Spezialtrick/HM-MyS-Relay-Board/Schematic/1.1/HM-MYS_relay_board_v1.1_top.jpg

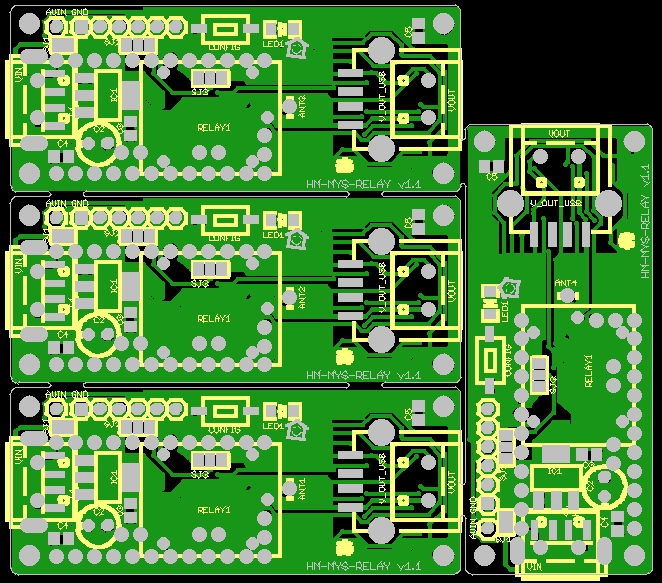
Schematic/1.1/HM-MYS_relay_board_v1.1_top.jpg
