Spezialtrick/HM-MyS-Relay-Board/Images/RelayBoard-1.0-3.jpg

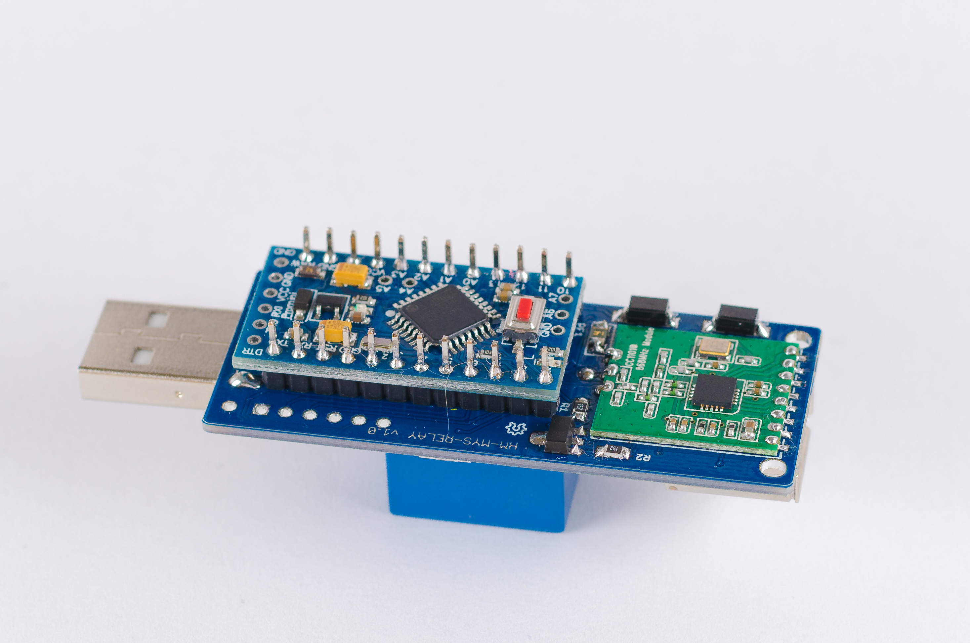
Images/RelayBoard-1.0-3.jpg
