Spezialtrick/HM-MyS-Relay-Board/README.md

# HM-MyS-Relay-Board

https://forum.fhem.de/index.php/topic,48235.0.html
