Spezialtrick/HM-MyS-Relay-Board/Case/Bildschirmfoto 2016-05-17 um 20.59.44.png

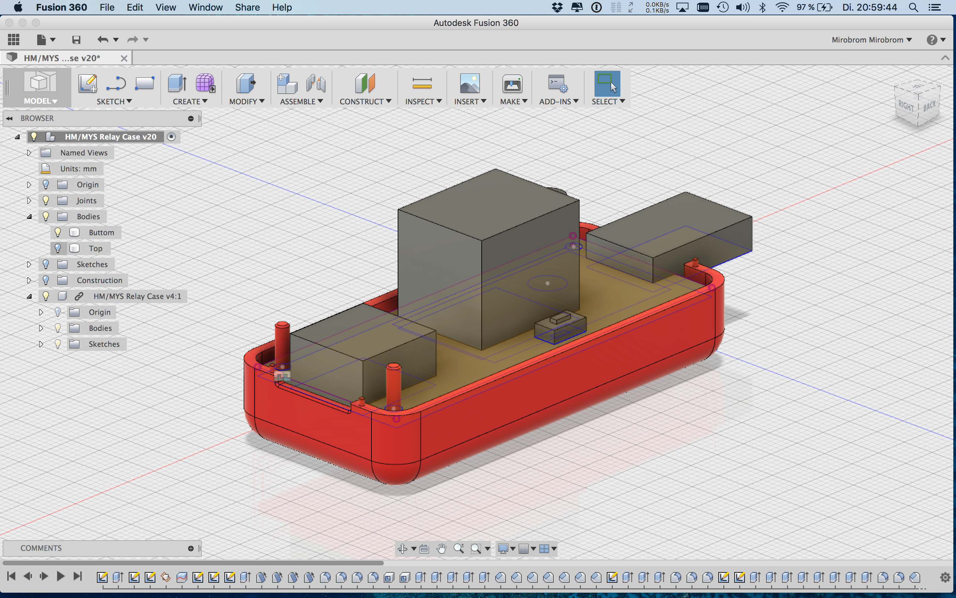
Case/Bildschirmfoto 2016-05-17 um 20.59.44.png
