Spezialtrick/HM-MyS-Relay-Board/Case/Bildschirmfoto 2016-05-17 um 21.00.06.png

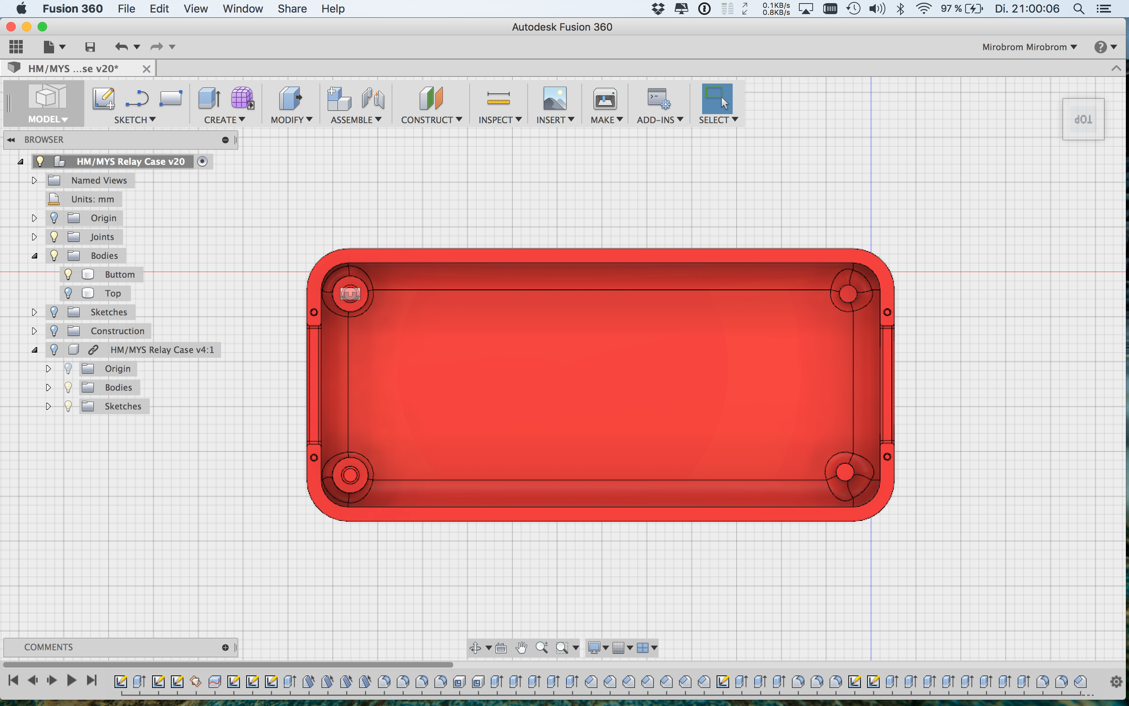
Case/Bildschirmfoto 2016-05-17 um 21.00.06.png
