Spezialtrick/HM-MyS-Relay-Board/Images/RelayBoard-1.0-1.jpg

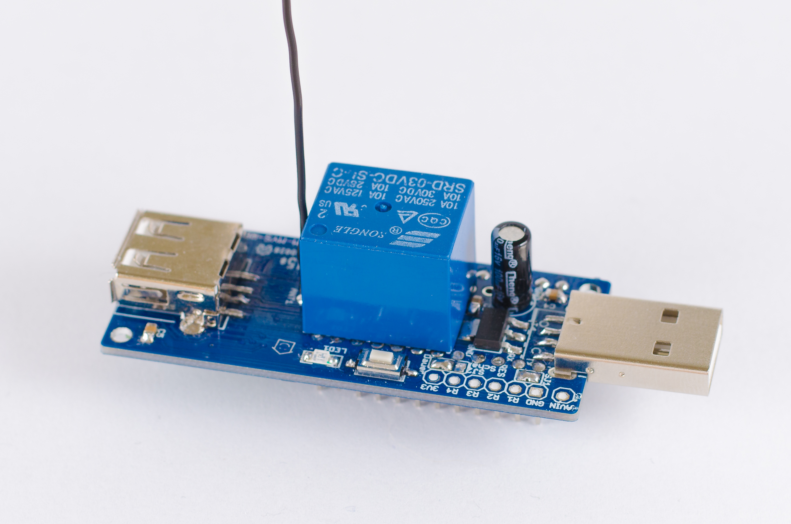
Images/RelayBoard-1.0-1.jpg
