Spezialtrick/HM-MyS-Relay-Board/Images/RelayBoard-1.0-2.jpg

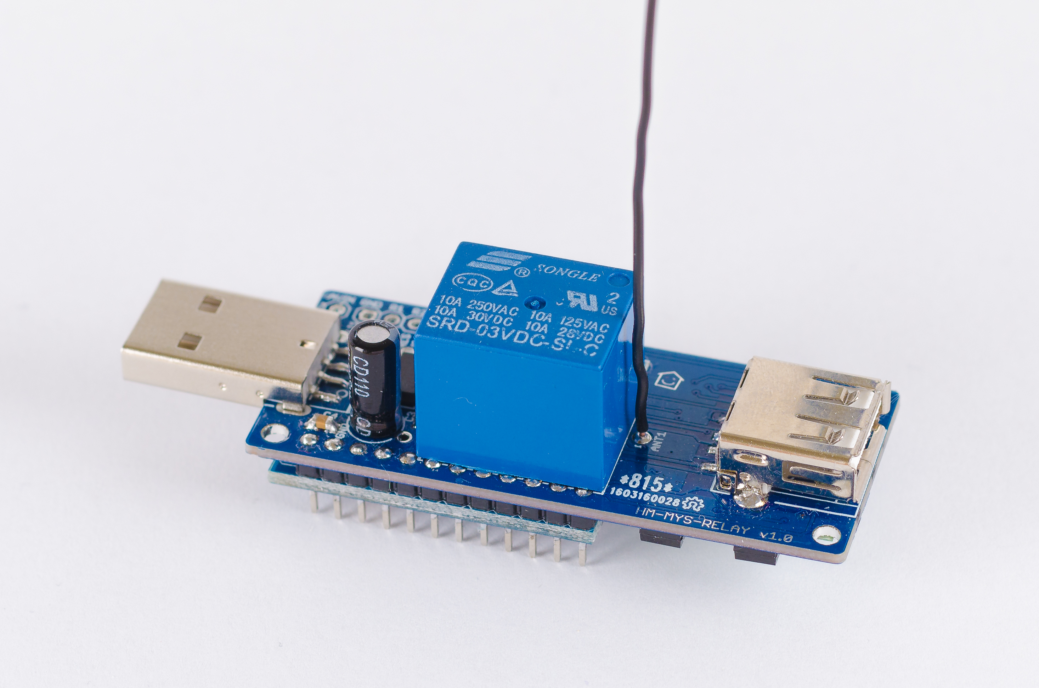
Images/RelayBoard-1.0-2.jpg
