Spezialtrick/HM-MyS-Relay-Board/Images/RelayBoard-1.0-4.jpg

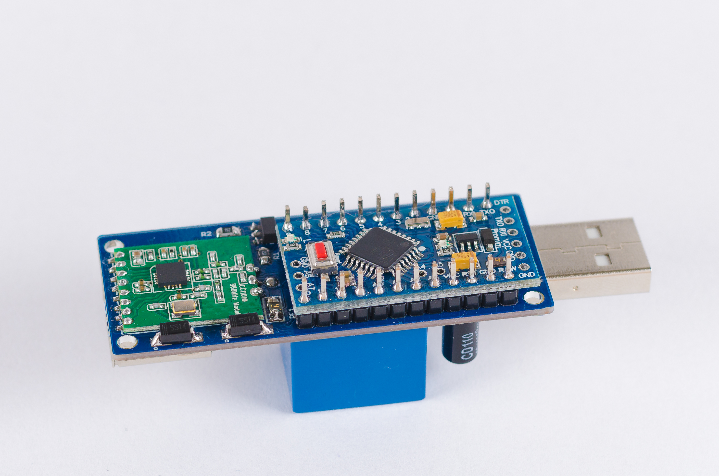
Images/RelayBoard-1.0-4.jpg
