Spezialtrick/HM-MyS-Relay-Board/Case/Bottom.stl

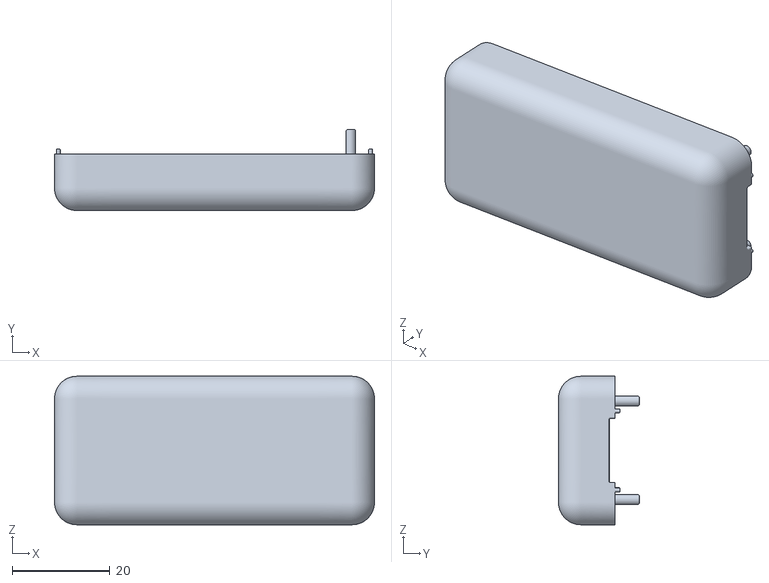
[picture p14: CAD file, 2017-06-06]
Case/Bottom.stl
65.5 x 16.6 x 30.4
