Spezialtrick/HM-MyS-Relay-Board/Schematic/1.1/Partslist.pdf

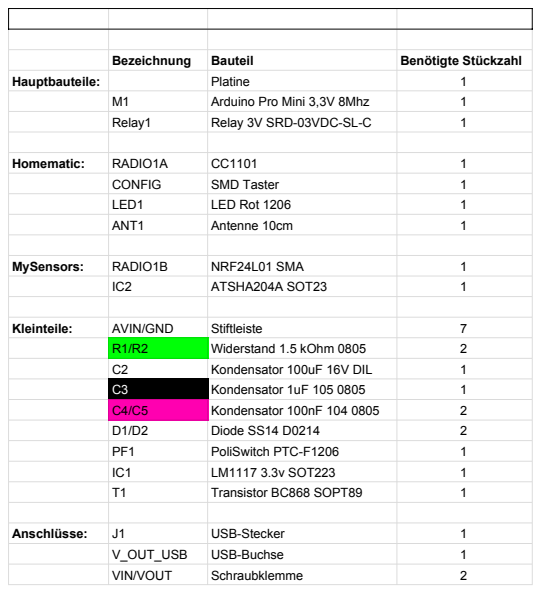
[picture p15: page 1]
Bezeichnung; Bauteil; Benötigte Stückzahl; Hauptbauteile:; Platine; Arduino Pro Mini 3,3V 8Mhz; Relay1; Relay 3V SRD-03VDC-SL-C; Homematic:; RADIO1A; CONFIG; SMD Taster; LED1; LED Rot 1206; ANT1; Antenne 10cm; MySensors:; RADIO1B; NRF24L01 SMA; ATSHA204A SOT23; Kleinteile:; AVIN/GND; Stiftleiste; Widerstand 1.5 kOhm 0805; Kondensator 100uF 16V DIL; Diode SS14 D0214; PoliSwitch PTC-F1206; LM1117 3.3v SOT223; Transistor BC868 SOPT89; Anschlüsse:; USB-Stecker; V_OUT_USB; USB-Buchse; VIN/VOUT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

C3 | Kondensator 1uF 105 0805 1
C4/C5 | Kondensator 100nF 104 0805 2
