Spezialtrick/HM-MyS-Relay-Board/Schematic/1.1/HM-MYS_relay_board_v1.1.brd

## EAGLE design Schematic/1.1/HM-MYS_relay_board_v1.1.brd (2017-07-14)

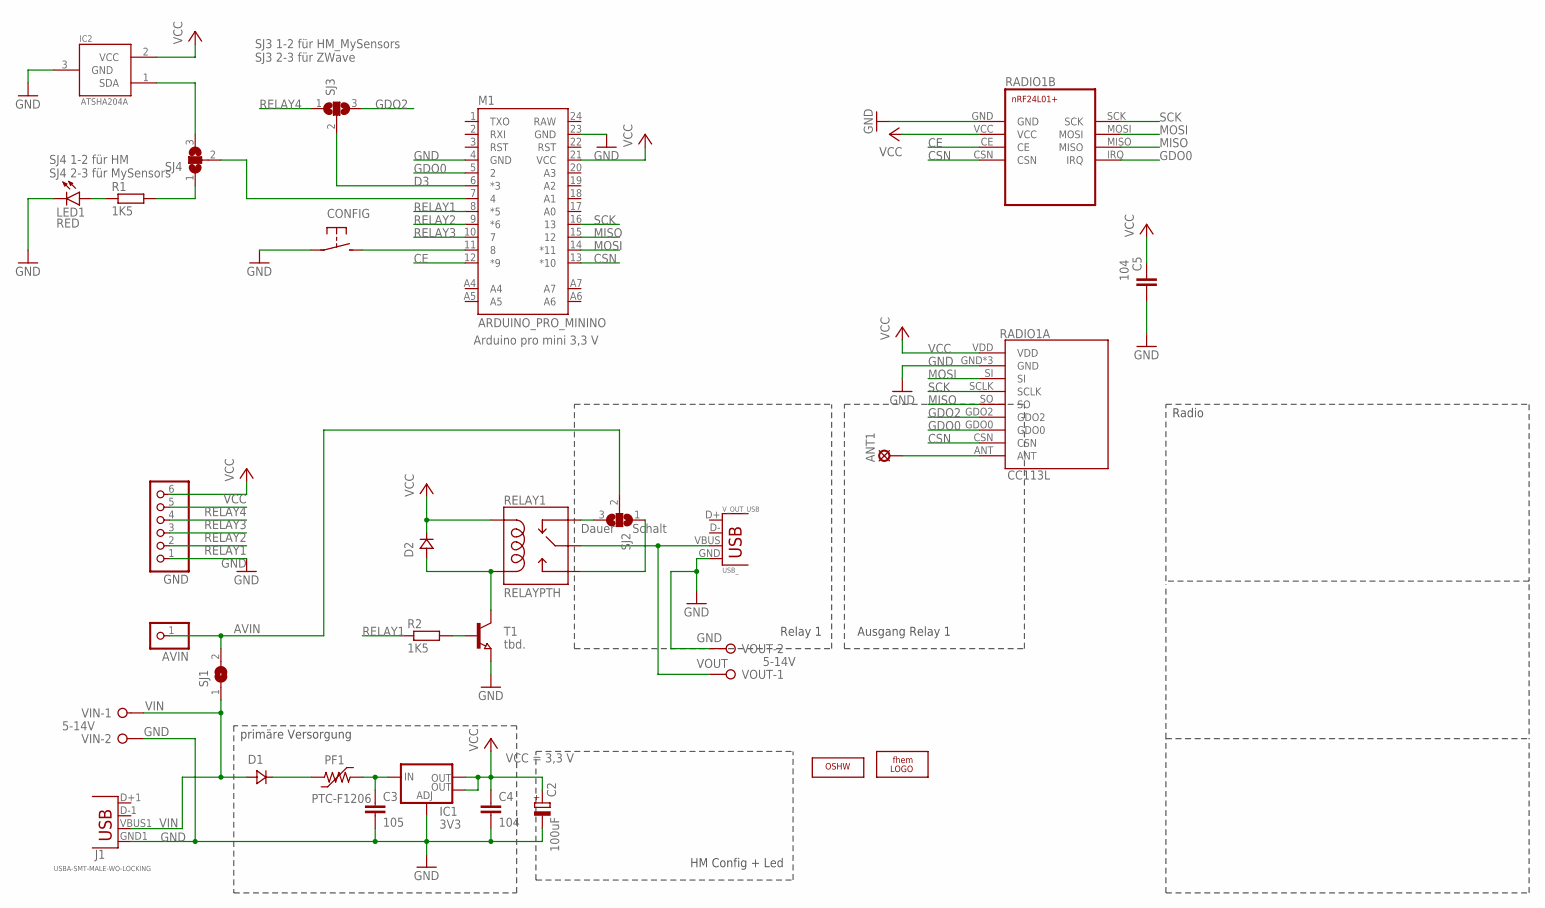
[picture p16: schematic HM-MYS_relay_board_v1.1.sch]

Parts:
ANT1: LSP10
AVIN: PINHD-1X1; 1X01
C2: 100uF; E2,5-6E
C3: 105; C0805
C4, C5: 104; C0805
CONFIG: TASTER-SMD
D1, D2: SS14; DO214
GND: PINHD-1X6_S; 1X06
IC1: 3V3; SOT223
IC2: ATSHA204A; SOT23-3
J1: USBA-SMT-MALE-WO-LOCKING; USB-A-SMT-MALE-NO_LOCKING
LED1: RED; LED-1206
LOGO2: LOGO_OSHWX0070; OSHW_6X70
M1: ARDUINO_PRO_MININO; ARDUINO_PRO_MINI_O
PF1: PTC-F1206; F1206
R1, R2: 1K5; R0805_SMALL_GAP
RADIO1A: CC113L
RADIO1B: NRF24L01+NRF24L01+MINI; NRF24L01+MINI
RELAY1: RELAYPTH; SRD-05VDC-SL-C
SJ1: SJ
SJ2, SJ3, SJ4: SJ2W; SJ_2
T1: tbd.; SOT89
U$2: LOGO_FHEMSTOP; LOGO_FHEM_3X3_STOP
VIN: W237-132
VOUT: W237-132
V_OUT_USB: USB_; USB-A-S-SILK-FEMALE

Connections:
ATSHA: IC2.1 (SDA), SJ4.3
AVIN: AVIN.1, SJ1.2, SJ2.2
CE: M1.12 (*9), RADIO1B.CE
CSN: M1.13 (*10), RADIO1A.CSN, RADIO1B.CSN
D3: M1.6 (*3), SJ3.2
D4: M1.7 (4), SJ4.2
DAUER: RELAY1.SWCLOSED (SWCLOSE), SJ2.3
GDO0: M1.5 (2), RADIO1A.GDO0, RADIO1B.IRQ
GDO2: RADIO1A.GDO2, SJ3.3
GND: C2.-, C3.2, C4.2, C5.2, CONFIG.1, GND.1, IC1.1 (ADJ), IC2.3 (GND), J1.GND1 (GND), LED1.C, M1.4 (GND), M1.23 (GND), RADIO1A.GND, RADIO1A.GND1 (GND), RADIO1A.GND2 (GND), RADIO1B.GND, T1.3 (E), VIN.2, VOUT.2, V_OUT_USB.GND
LED: R1.2, SJ4.1
MISO: M1.15 (12), RADIO1A.SO, RADIO1B.MISO
MOSI: M1.14 (*11), RADIO1A.SI, RADIO1B.MOSI
unnamed: CONFIG.2 (S), M1.11 (8)
unnamed: LED1.A, R1.1
unnamed: ANT1.1, RADIO1A.ANT
unnamed: D2.ANODE, RELAY1.COIL0, T1.2 (C)
unnamed: R2.2, T1.1 (B)
RELAY1: GND.2, M1.8 (*5), R2.1
RELAY2: GND.3, M1.9 (*6)
RELAY3: GND.4, M1.10 (7)
RELAY4: GND.5, SJ3.1
SCHALT: RELAY1.SWOPEN, SJ2.1
SCK: M1.16 (13), RADIO1A.SCLK, RADIO1B.SCK
VCC: C2.+, C4.1, C5.1, D2.CATHODE, GND.6, IC1.2 (OUT), IC1.4 (OUT), IC2.2 (VCC), M1.21 (VCC), RADIO1A.VDD, RADIO1B.VCC, RELAY1.COIL1
VIN: D1.ANODE, J1.VBUS1 (VBUS), SJ1.1, VIN.1
VOUT: RELAY1.SWCOMMON, VOUT.1, V_OUT_USB.VBUS
VREG_IN: C3.1, IC1.3 (IN), PF1.2
VUSB: D1.CATHODE, PF1.1

Notes on the sheet:
primäre Versorgung
5-14V
Radio
HM Config + Led
Relay 1
Ausgang Relay 1
Dauer
Schalt
SJ3 1-2 für HM_MySensors SJ3 2-3 für ZWave
Arduino pro mini 3,3 V
VCC = 3,3 V
SJ4 1-2 für HM SJ4 2-3 für MySensors

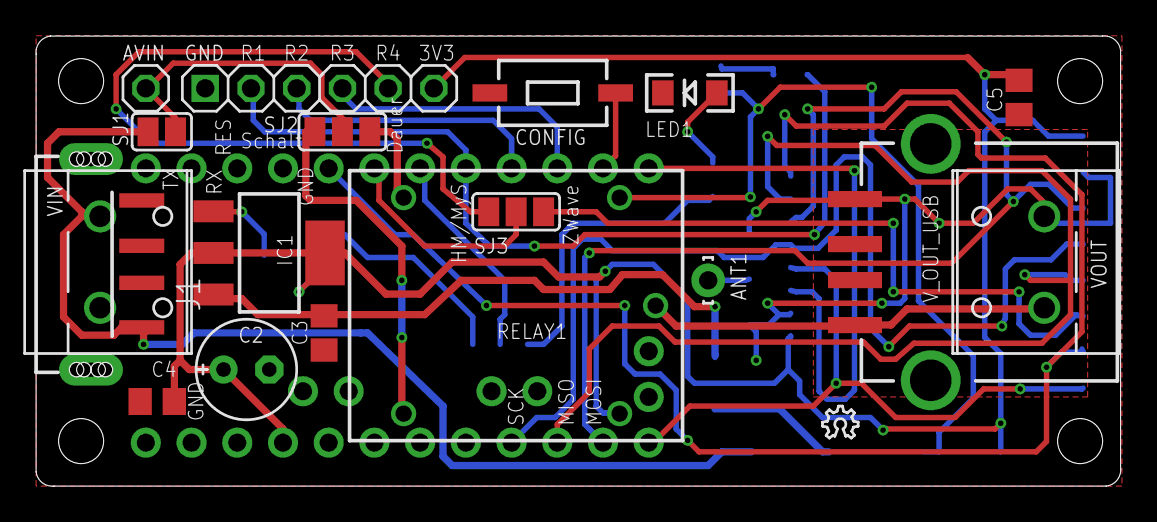
[picture p17: board HM-MYS_relay_board_v1.1.brd from above]

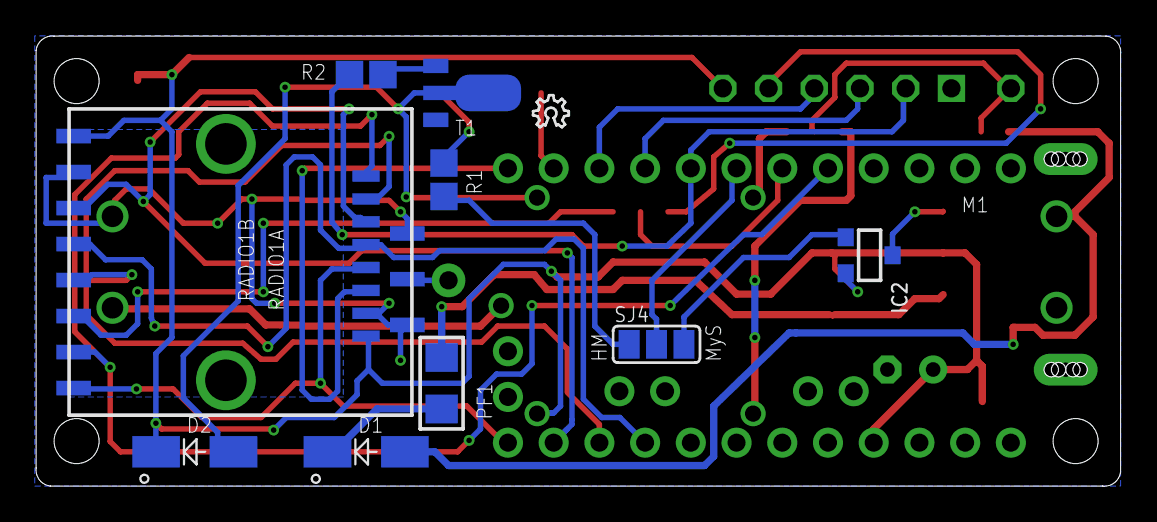
[picture p18: board HM-MYS_relay_board_v1.1.brd from below]

Board: 2 copper layers, 60.3 x 25.0 mm, 32 parts (12 on the bottom side), 29 nets.

Other parts of the board:
LOGO1: LOGO_OSHWX0070; OSHW_6X70
