Spezialtrick/HM-MyS-Relay-Board/Firmware/MySensors/MySensors.ino

/**
 * The MySensors Arduino library handles the wireless radio link and protocol
 * between your home built sensors/actuators and HA controller of choice.
 * The sensors forms a self healing radio network with optional repeaters. Each
 * repeater and gateway builds a routing tables in EEPROM which keeps track of the
 * network topology allowing messages to be routed to nodes.
 *
 * Created by Henrik Ekblad <henrik.ekblad@mysensors.org>
 * Copyright (C) 2013-2015 Sensnology AB
 * Full contributor list: https://github.com/mysensors/Arduino/graphs/contributors
 *
 * Documentation: http://www.mysensors.org
 * Support Forum: http://forum.mysensors.org
 *
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
 *******************************
 *
 * REVISION HISTORY
 * Version 1.0 - Henrik Ekblad
 *
 * DESCRIPTION
 * Example sketch showing how to control physical relays.
 * This example will remember relay state after power failure.
 * http://www.mysensors.org/build/relay
 */

// Enable debug prints to serial monitor
#define MY_DEBUG

// Enable and select radio type attached
#define MY_RADIO_NRF24
//#define MY_RADIO_RFM69

// Enable repeater functionality for this node
#define MY_REPEATER_FEATURE

#include <MySensors.h>

const int RELAY_1[]= {5, 6, 7, 3}; // Arduino Digital I/O pin number for first relay (second on pin+1 etc)
#define NUMBER_OF_RELAYS 4 // Total number of attached relays
#define RELAY_ON 1  // GPIO value to write to turn on attached relay
#define RELAY_OFF 0 // GPIO value to write to turn off attached relay


void before()
{
  for (int sensor=1, pin=0; sensor<=NUMBER_OF_RELAYS; sensor++, pin++) {
    // Then set relay pins in output mode
    pinMode(RELAY_1[pin], OUTPUT);
    // Set relay to last known state (using eeprom storage)
    digitalWrite(RELAY_1[pin], loadState(sensor)?RELAY_ON:RELAY_OFF);
  }
}

void setup()
{

}

void presentation()
{
  // Send the sketch version information to the gateway and Controller
  sendSketchInfo("Relay", "1.0");
 
  for (int sensor=1, pin=0, RELAY_1[pin]; sensor<=NUMBER_OF_RELAYS; sensor++, pin++) {
    // Register all sensors to gw (they will be created as child devices)
    present(sensor, S_BINARY);
  }
}


void loop()
{

}

void receive(const MyMessage &message)
{
  // We only expect one type of message from controller. But we better check anyway.
  if (message.type==V_STATUS) {
    // Change relay state
    digitalWrite(RELAY_1[message.sensor-1], message.getBool()?RELAY_ON:RELAY_OFF);
    // Store state in eeprom
    saveState(message.sensor, message.getBool());
    // Write some debug info
    Serial.print("Incoming change for sensor:");
    Serial.print(message.sensor);
    Serial.print(", New status: ");
    Serial.println(message.getBool());
  }
}
