Spezialtrick/HM-MyS-Relay-Board/(commit log)

2017-06-06 pcb v1.1 panel added
    [HM-MYS_relay_board_v1.1.GBL, HM-MYS_relay_board_v1.1.GBO, HM-MYS_relay_board_v1.1.GBS, HM-MYS_relay_board_v1.1.GKO, HM-MYS_relay_board_v1.1.GTL, HM-MYS_relay_board_v1.1.GTO, HM-MYS_relay_board_v1.1.GTS]
2017-07-14 Fixed Version
    [HM-MYS_relay_board_v1.1.brd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]
