Spezialtrick/HM-MyS-Relay-Board/(notices)

Notices in the files:
Firmware/MySensors/MySensors.ino:
modify it under the terms of the GNU General Public License
parts and their libraries:
SparkFun-PowerIC: Licensing: Creative Commons ShareAlike 4.0 International - https://creativecommons.org/licenses/by-sa/4.0
polyswitch: Copyright (C) 2008, Bob Starr
